rwinkhart/LoRaComm/big-resources/fritzing.webp

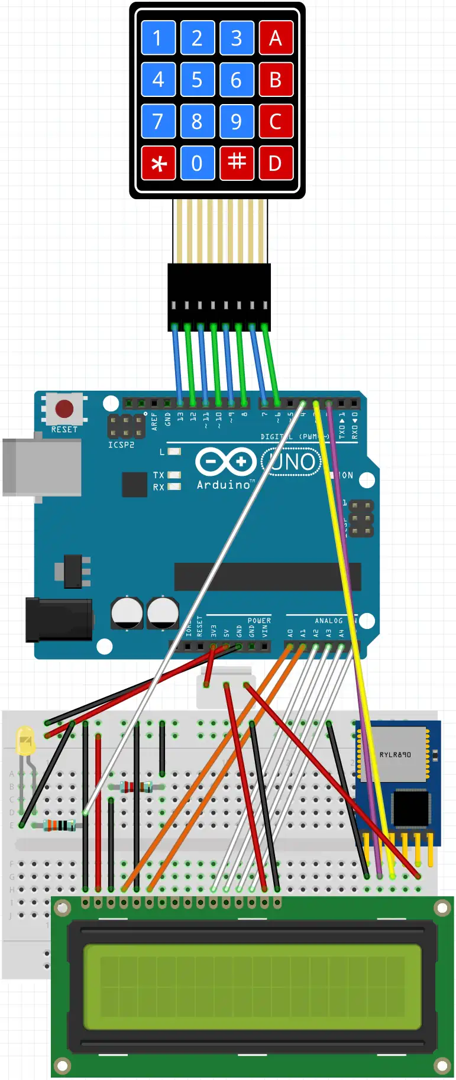
big-resources/fritzing.webp
