rwinkhart/LoRaComm/big-resources/keypad.webp

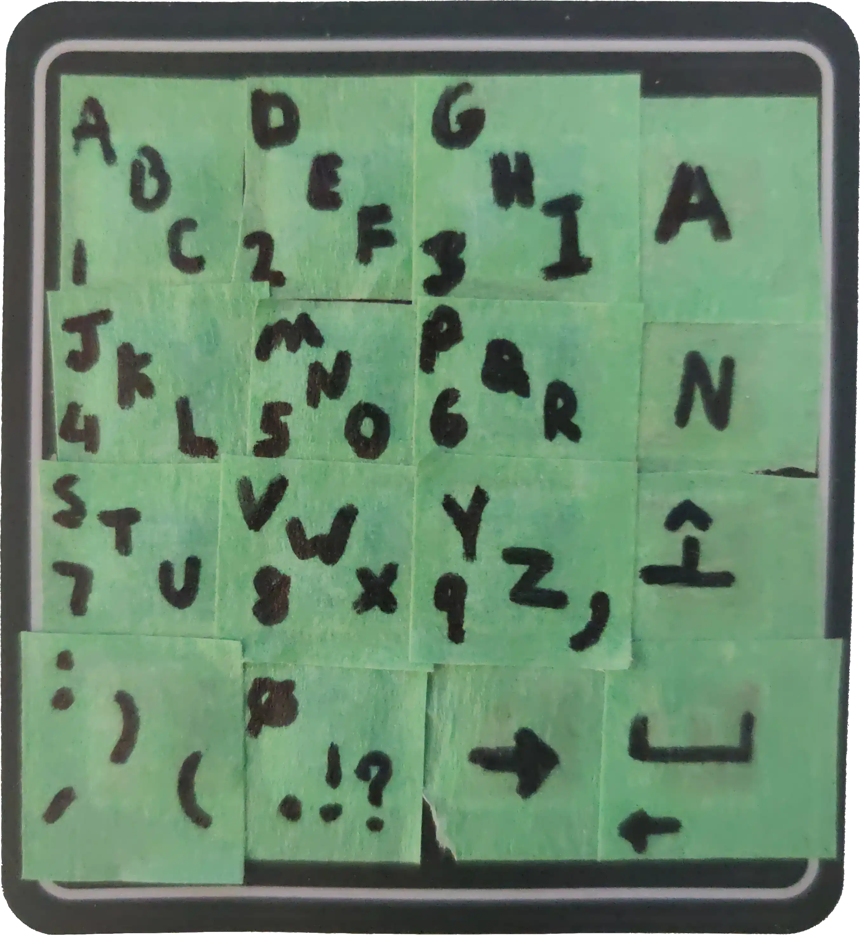
big-resources/keypad.webp
