rwinkhart/LoRaComm/cpp-deps.md

[Keypad v3.1.1 by Mark Stanley, Alexander Brevig](https://github.com/Chris--A/Keypad)

[ArduinoDES by Tim Riemann](https://github.com/Octoate/ArduinoDES)
