rwinkhart/LoRaComm/(commit log)

2024-09-26 Fix improper handling of LCD rows after send key is used
    [main.ino]
2024-11-03 Implement initial encryption support (current desKey is a placeholder)
2024-11-05 Add Node-RED web GUI flows.json file
2024-11-08 Fix buffer overflow when sending 32 length messages portably
    [2lora.ino]
2024-11-09 Fix possible buffer overflow during encryption
    [2lora.ino]
2024-11-09 Swap GUI reply indicator from gauge to switch
2024-11-09 Display incoming messages on portable LCD; add docked mode to avoid blocking when message is received
    [1loracomm.ino, 2lora.ino, 3keypad.ino, 4lcd.ino, 5led.ino, main.ino]
2024-11-10 Add re-send button to GUI
2024-11-10 Replace reply indicator switch with text
2024-11-12 Replace unused inbox key with ":)(\'" options
    [1loracomm.ino, 3keypad.ino]
2024-11-12 Fix freeze when attempting to backspace past cursor position 1
    [3keypad.ino]
2024-11-13 Replace references to T9 dialing with multi-press dialing
    [1loracomm.ino, 3keypad.ino, main.ino]
